okritvik/Omni-Wheel-Robot/Images/Block_diagram.png

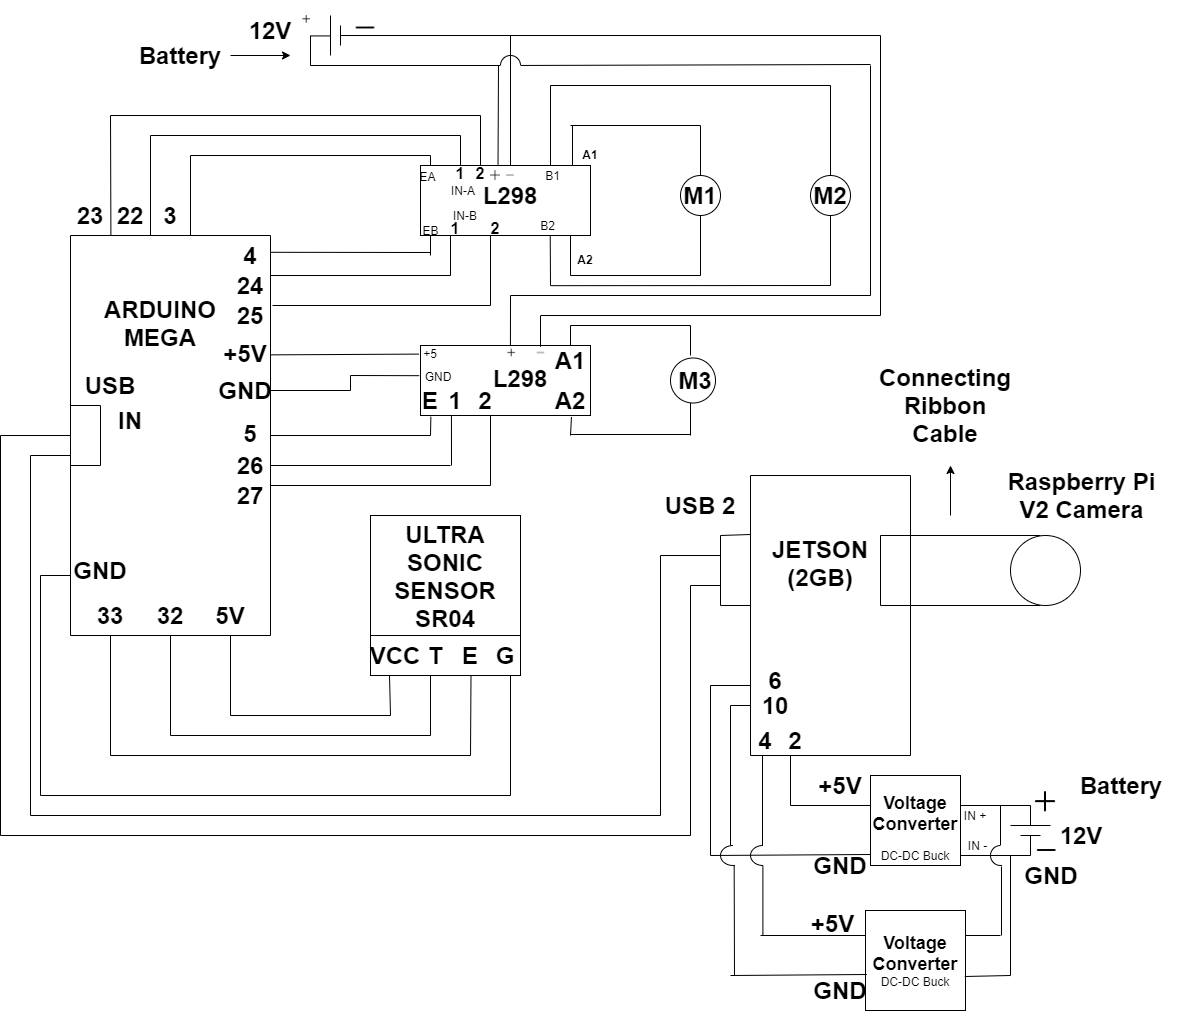
Images/Block_diagram.png
